valeeriaaguirre-dev/CPS-Group-19--Sealia/(commit log)

2026-11-12 Processing code
    This Processing code connects Wekinator to Arduino. It sends colour data from the camera to Wekinator, receives the predicted class, and forwards it to Arduino to control the seal robot’s movements.
2026-11-12 Add Arduino code for servo control and tail clapping
    This Arduino code receives class predictions from Processing and controls the seal robot’s servos. Each class triggers a different behaviour, including raising or waving the arms, moving the tail, and tilting the platform.
